fyhertz/epilepsia/schematics/epilepsia.sch

## KiCad design schematics/epilepsia.sch (2018-05-09)

Schematic: epilepsia.sch

Parts:
C0: 0.1uF
C1: 2.2uF
P8, P9: Conn_02x23_Odd_Even
R0: 100
U0, U1, U2, U3: 74HC4094
