fyhertz/epilepsia/arm/leddriver.cpp

/*
 * Copyright (C) 2018-2019 Simon Guigui
 *
 * Licensed under the Apache License, Version 2.0 (the "License");
 * you may not use this file except in compliance with the License.
 * You may obtain a copy of the License at
 *
 *     http://www.apache.org/licenses/LICENSE-2.0
 *
 * Unless required by applicable law or agreed to in writing, software
 * distributed under the License is distributed on an "AS IS" BASIS,
 * WITHOUT WARRANTIES OR CONDITIONS OF ANY KIND, either express or implied.
 * See the License for the specific language governing permissions and
 * limitations under the License.
 */

#include "leddriver.hpp"
#include <spdlog/spdlog.h>
#include <algorithm>
#include <array>

namespace epilepsia {

/**
 * strip_length has to be a multiple of 4
 * strip_count can be 8, 16 or 32
 */
led_driver::led_driver(led_driver_settings& settings)
    : strip_length_(settings.strip_length)
    , strip_count_(settings.strip_count)
    , bytes_per_strip_(settings.strip_length * 3)
    , frame_buffer_size_(bytes_per_strip_ * settings.strip_count)
    , settings_(settings)
    , pru_driver_(strip_length_, strip_count_)
{

    // remap_bits needs strip_length > 4
    if (strip_length_ % 4 != 0) {
        spdlog::error("The length of your strips has to be a multiple of 4");
        std::exit(EXIT_FAILURE);
    }

    if (strip_count_ != 8 && strip_count_ != 16 && strip_count_ != 32) {
        spdlog::error("Invalid number of strips: {}", strip_count_);
        std::exit(EXIT_FAILURE);
    }

    // PRU shared mem = 12kiB (or is it 12 kB?)
    const int max = 12 * 1024 - 4;
    if (frame_buffer_size_ > max) {
        spdlog::error("Frame buffer too big: {} > {}", frame_buffer_size_, max);
        std::exit(EXIT_FAILURE);
    }

    residual_.resize(frame_buffer_size_);
    update_lut();

    spdlog::info("Strip count: {}", strip_count_);
    spdlog::info("Strip length: {}", strip_length_);
    spdlog::info("Frame buffer size: {}", frame_buffer_size_);
}

led_driver::~led_driver()
{
}

void led_driver::set_brightness(float brightness) {
    settings_.brightness = brightness;
    update_lut();
}

void led_driver::clear()
{
    uint8_t buf[frame_buffer_size_];
    std::fill(buf, buf + frame_buffer_size_, 0);
    pru_driver_.write_frame(buf, frame_buffer_size_);
}

void led_driver::commit_frame_buffer(uint8_t* buffer, int len)
{
    uint8_t tmp[frame_buffer_size_];

    if (len < frame_buffer_size_) {
        std::copy_n(buffer, len, tmp);
        buffer = tmp;
    }

    // RGB to GRB
    for (auto i = 0; i < frame_buffer_size_; i += 3) {
        uint8_t p = buffer[i];
        buffer[i] = buffer[i + 1];
        buffer[i + 1] = p;
    }

    if (settings_.zigzag) {
        // Every two lines of the display is wired upside-down
        for (auto i = bytes_per_strip_ / 2; i < frame_buffer_size_; i += bytes_per_strip_) {
            for (auto j = 0; j < bytes_per_strip_ / 4; j += 3) {
                uint8_t p = buffer[i + j];
                buffer[i + j] = buffer[i + bytes_per_strip_ / 2 - 1 - j - 2];
                buffer[i + bytes_per_strip_ / 2 - 1 - j - 2] = p;

                p = buffer[i + j + 1];
                buffer[i + j + 1] = buffer[i + bytes_per_strip_ / 2 - 1 - j - 1];
                buffer[i + bytes_per_strip_ / 2 - 1 - j - 1] = p;

                p = buffer[i + j + 2];
                buffer[i + j + 2] = buffer[i + bytes_per_strip_ / 2 - 1 - j];
                buffer[i + bytes_per_strip_ / 2 - 1 - j] = p;
            }
        }
    }

    if (settings_.dithering) {
        update_buffer<true>(buffer);
    } else {
        update_buffer<false>(buffer);
    }

    uint32_t* in = reinterpret_cast<uint32_t*>(buffer);
    uint32_t out[frame_buffer_size_ / 4];

    if (strip_count_ == 8) {
        remap_bits<uint8_t>(in, out, bytes_per_strip_ / 4);
    } else if (strip_count_ == 16) {
        remap_bits<uint16_t>(in, out, bytes_per_strip_ / 4);
    } else {
        remap_bits<uint32_t>(in, out, bytes_per_strip_ / 4);
    }

    pru_driver_.write_frame(out, frame_buffer_size_ / 4);
}

template <bool dithering>
void led_driver::update_buffer(uint8_t* buffer)
{
    for (auto i = 0; i < frame_buffer_size_; i++) {

        // Gamma correction and brightness adjustment
        int d = lut_[buffer[i]];

        // Temporal dithering
        if (dithering) {

            // Compiles to a single usat ARM instruction
            auto usat = [](int a) {
                return a > 65535 ? 65535 : a < 0 ? 0 : a;
            };

            d += residual_[i];
            int e = usat(d + 0x80) >> 8;
            residual_[i] = d - (e * 257);
            buffer[i] = e;

        } else {
            buffer[i] = d >> 8;
        }
    }
}

template <typename T>
void led_driver::remap_bits(uint32_t* in, uint32_t* out, const int len)
{
    constexpr const uint32_t mask = sizeof(T) == 4 ? 0x00000001 : sizeof(T) == 2 ? 0x00010001 : 0x01010101;

    for (auto i = 0, ii = 0; i < len; i++, ii += 32) {
        for (size_t l = 0; l < sizeof(T) * 8; l += 8) {
            for (auto j = 0; j < 8; j++) {
                uint32_t m = 0;
                for (size_t k = 0, kk = 0; k < sizeof(T) * 8; k++, kk += len) {
                    uint32_t n = in[i + kk];
                    m |= (((n >> (7 + l - j)) & mask) << (sizeof(T) * 8 - 1 - k));
                }
                for (size_t k = 0; k < 32; k += sizeof(T) * 8) {
                    reinterpret_cast<T*>(out)[ii + j + l + k] = (m >> k) & static_cast<T>(0xFFFFFFFF);
                }
            }
        }
    }
}

void led_driver::update_lut()
{
    static const std::array<uint8_t, 256> gamma8{
        0, 0, 0, 0, 0, 0, 0, 0, 0, 0, 0, 0, 0, 0, 0, 0,
        0, 0, 0, 0, 0, 0, 0, 0, 0, 0, 0, 0, 1, 1, 1, 1,
        1, 1, 1, 1, 1, 1, 1, 1, 1, 2, 2, 2, 2, 2, 2, 2,
        2, 3, 3, 3, 3, 3, 3, 3, 4, 4, 4, 4, 4, 5, 5, 5,
        5, 6, 6, 6, 6, 7, 7, 7, 7, 8, 8, 8, 9, 9, 9, 10,
        10, 10, 11, 11, 11, 12, 12, 13, 13, 13, 14, 14, 15, 15, 16, 16,
        17, 17, 18, 18, 19, 19, 20, 20, 21, 21, 22, 22, 23, 24, 24, 25,
        25, 26, 27, 27, 28, 29, 29, 30, 31, 32, 32, 33, 34, 35, 35, 36,
        37, 38, 39, 39, 40, 41, 42, 43, 44, 45, 46, 47, 48, 49, 50, 50,
        51, 52, 54, 55, 56, 57, 58, 59, 60, 61, 62, 63, 64, 66, 67, 68,
        69, 70, 72, 73, 74, 75, 77, 78, 79, 81, 82, 83, 85, 86, 87, 89,
        90, 92, 93, 95, 96, 98, 99, 101, 102, 104, 105, 107, 109, 110, 112, 114,
        115, 117, 119, 120, 122, 124, 126, 127, 129, 131, 133, 135, 137, 138, 140, 142,
        144, 146, 148, 150, 152, 154, 156, 158, 160, 162, 164, 167, 169, 171, 173, 175,
        177, 180, 182, 184, 186, 189, 191, 193, 196, 198, 200, 203, 205, 208, 210, 213,
        215, 218, 220, 223, 225, 228, 231, 233, 236, 239, 241, 244, 247, 249, 252, 255
    };

    for (auto i = 0; i < 256; i++) {
        // lut_[i] between 0 and 0xFFFF
        lut_[i] = gamma8[i] * 257 * (settings_.brightness > 1.f ? 1.f : settings_.brightness);
    }
}
}
