fyhertz/epilepsia/(commit log)

2018-04-01 LedDisplay now is a singleton.
2018-04-07 Fixes glitches at the bottom of the panel.
    [leddisplay.cpp, main.cpp]
2018-04-10 Added a copy of the Apache 2.0 license. Versioning of the kikad schematic. Updated schematic.
    [epilepsia.sch]
2018-04-12 std::thread in opc::Source no longer heap allocated.
    [main.cpp]
2018-05-09 Double buffering not needed anymore between the pru and the arm
2018-05-09 Each PRU can now handle 16 led strips.
2018-05-09 Add frame rate limiter in python scripts.
2018-05-09 Support for 8, 16 or 32 led strips
2018-05-09 Updated Schematic.
    [epilepsia.sch]
2018-05-12 Exclude third party libs from codacy. Small fix in ARM Makefile.
    [opcserver.cpp, sha1.hpp]
2018-05-29 Better config file. Some fixes.
    [leddriver.cpp, leddriver.hpp, main.cpp]
2018-08-27 Small bug fix when writing the config
    [main.cpp]
2019-03-23 Fix some code quality issues
    [prudriver.cpp, settings.cpp, settings.hpp]
2019-12-07 bug fix when saving settings
    [leddriver.cpp, leddriver.hpp, main.cpp, settings.cpp]
